Kauakim/ProjetoIntegradoT1/EsquemaEletrico.jpg

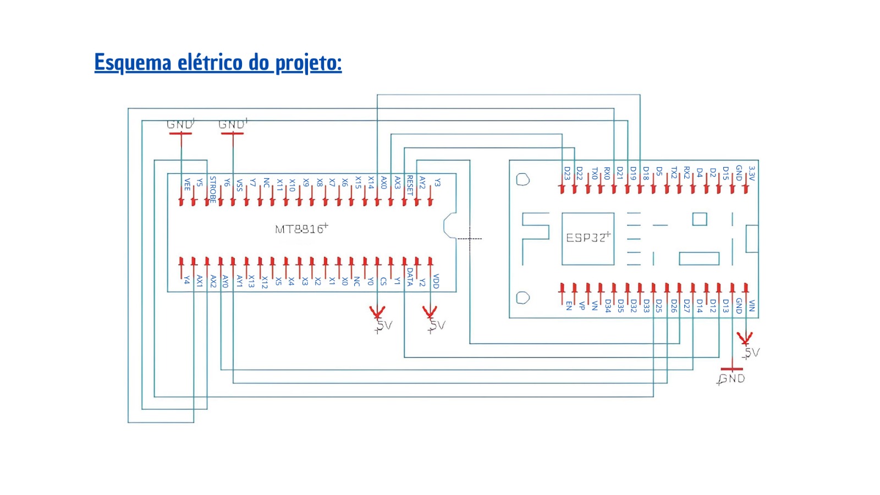
EsquemaEletrico.jpg
